Counterfeiter/PowerMeter-PCB/README.md

PowerMeter Schematic and PCB Files
==============

License
--------------
OSH - GPLv2

Software
--------------
Free Version of CADSoft Eagle v6 (.1)

Included
--------------
- versions history
- zipped farbication files (gerber, drill files)
- schematic
- PCB design
- Mouser BOM
