Counterfeiter/PowerMeter-PCB/Image/PowerMeterPCB.png

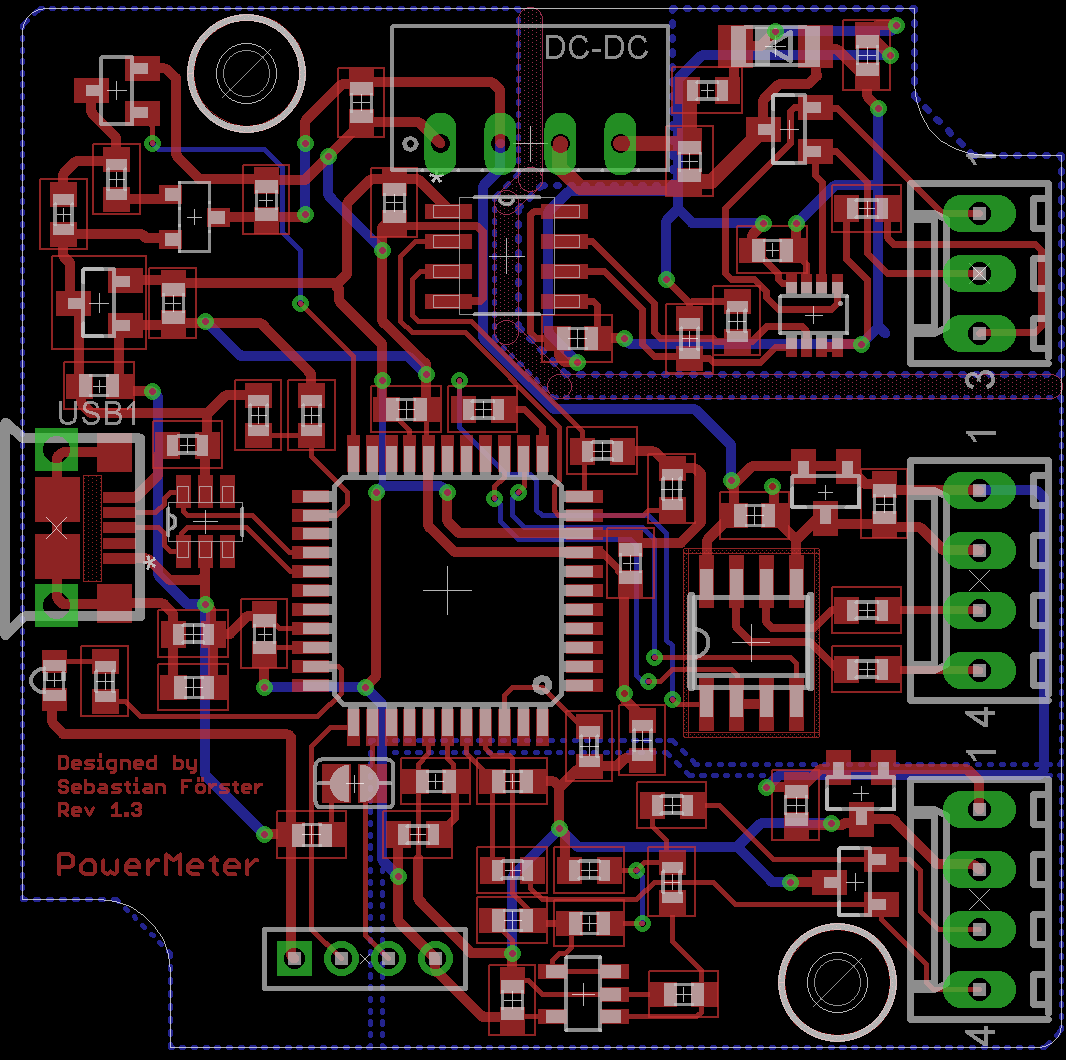
Image/PowerMeterPCB.png
