Counterfeiter/PowerMeter-PCB/Image/PowerMeterSchematic.png

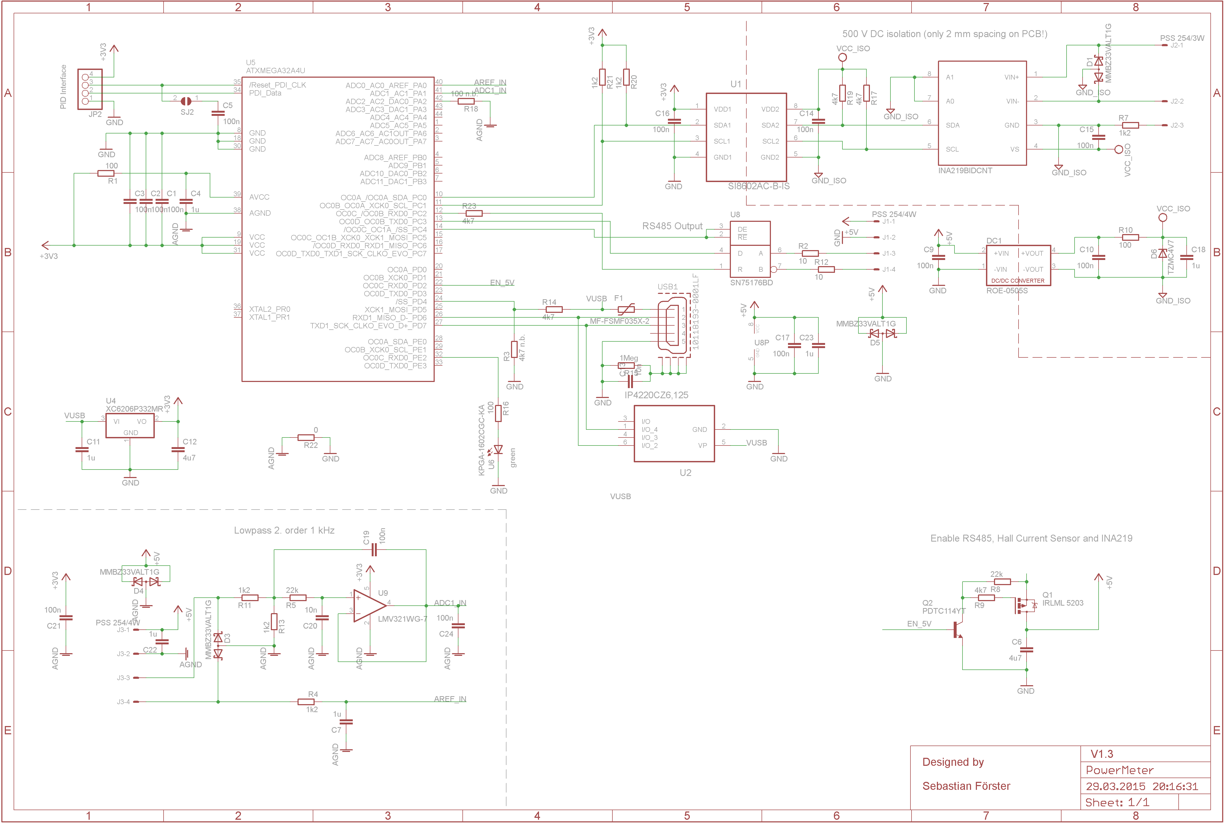
Image/PowerMeterSchematic.png
