Counterfeiter/PowerMeter-PCB/BOM/Mouser_PowerMeter.xlsx

Qty | Value | Package | Name | Order Number Mouser | Review
13 | 100n | C0603 | Kondensator | 81-GRM188R71E104JA1D | okay
6 | 1µ | C0603 | Kondensator | 581-0603YC105JAT2A | okay
2 | 4,7µ | C0603 | Kondensator | 81-ZRB18AR6YA475KE5L | okay
2 | 10n | C0603 | Kondensator | 810-CGA3E2C0G1H103J | okay
4 | MMBZ33VALT1G/BAS40-60 | SOT23 | Diode | 863-MMBZ33VALT1G | okay
1 | TZMC4V7 | SOD80C | Z-Diode | 78-TZMC4.7 | okay
1 | ROE-0505S | NME | dc Wandler | 919-ROE-0505S | okay
1 | MF-FSMF035X-2 | R0603 | Sicherung | 652-MFFSMF035X-2 | okay
2 | PSS 254/4W | 6410-04 | Pinleiste | 538-22-05-7048 | okay
1 | PSS 254/3W | 6410-03 | Pinleiste | 538-22-05-3031 | okay
1 |  |  | Steckerleiste | 538-22-01-3037 | okay
2 |  |  | Steckerleiste | 538-22-01-2045 | okay
11 |  |  | Steckerpins | 538-08-50-0114 | okay
1 | IRLML 5203 | MICRO3 | Transistor | 942-IRLML5203TRPBF | okay
1 | PDTC114YT | SOT23 | Transistor | 771-PDTC114YTT/R | okay
4 | 100 | R0603 | Widerstand | 71-CRCW0603-100-E3 | okay
2 | 10 | R0603 | Widerstand | 71-CRCW0603-10-E3 | okay
6 | 4k7 | R0603 | Widerstand | 71-CRCW0603-4.7K-E3 | okay
6 | 1k2 | R0603 | Widerstand | 71-TNPW06031K20BEEA | okay
2 | 22k | R0603 | Widerstand | 71-TNPW060322K0BEEA | okay
1 | 1M | R0603 | Widerstand | 71-CRCW0603-1.0M-E3 | okay
1 | 0 | R0603 | Widerstand | 71-CRCW0603-0-E3 | okay
1 | 800 |  | Hallsensor | Farnell-9135766 | Farnell! 800 A Example
1 | SI8602AC-B-IS/ADUM1250ARZ | SOIC127P600X175-8N | ADUM1250 | 634-SI8602AC-B-IS | okay
1 | IP4220CZ6,125/IP4220CZ6 | SOT95P275X110-6N | USB-ESD-NXP | 771-IP4220CZ6-T/R | okay
1 | XC6206P332MR | SOT23 | MCP1700T | 579-MCP1700T3302E/TT | okay
1 | ATXMEGA32A4U/AVR-XMEGA-A4U | TQFP44 | xmega | 556-ATXMEGA32A4U-AU | okay
1 | KPGA-1602CGC-KA/APA1606SURCK | CHIP-LED0603 | LED-Sideview | 604-APA1606ZGC | okay
1 | INA219BIDCNT | SOT23-8 | INA219 | 595-INA219BIDCNT | okay
1 | SN75176BD | SO-08 | texas | 595-SN75176BDR | okay
1 | LMV321WG-7 | SOT25-5 | linear | 621-LMV321WG-7 | okay
1 | 10118193-0001LF | MOLEX-47364-0001 | USB-con-Update | 649-10118193-0001LF | okay
1 | 1551RFLBK | Gehäuse | Gehäuse | 546-1551RFLBK | okay
