Counterfeiter/PowerMeter-PCB/PowerMeter.brd

## EAGLE design PowerMeter.brd (2015-04-04)

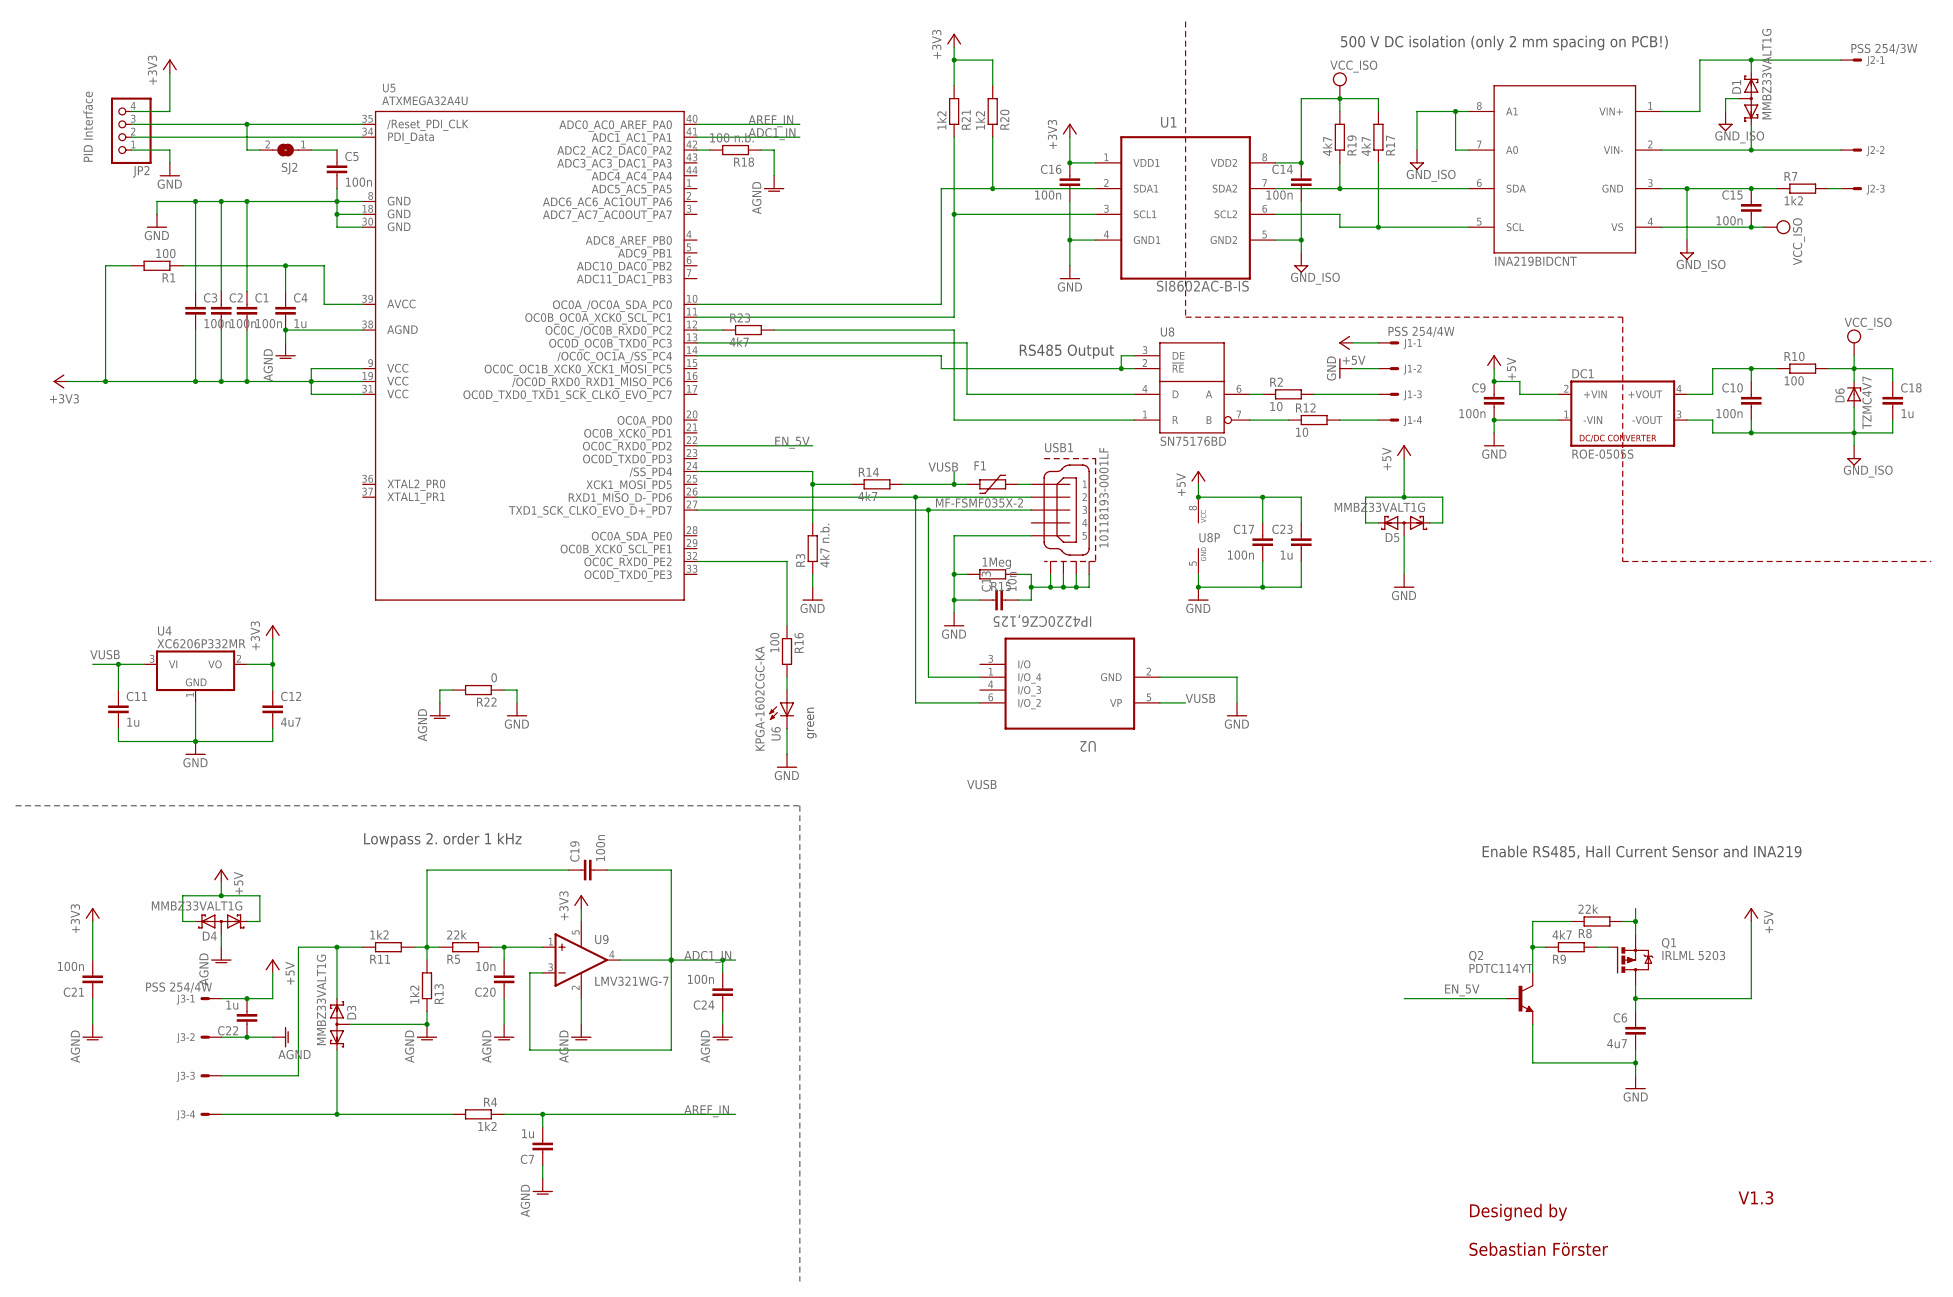
[picture p3: schematic PowerMeter.sch]

Parts:
C1, C2, C3, C5, C9, C10, C14, C15, C16, C17, C19, C21, C24: 100n; C0603
C4, C7, C11, C18, C22, C23: 1u; C0603
C6, C12: 4u7; C0603
C13, C20: 10n; C0603
D1, D3, D4, D5: MMBZ33VALT1G; SOT23
D6: TZMC4V7; SOD80C
DC1: ROE-0505S; NME
F1: MF-FSMF035X-2; R0603
J1, J3: PSS 254/4W; 6410-04
J2: PSS 254/3W; 6410-03
JP2: PINHD-1X4_2.00; 1X04M
Q1: IRLML 5203; MICRO3
Q2: PDTC114YT; SOT23
R1, R10, R16: 100; R0603
R2, R12: 10; R0603
R3: 4k7 n.b.; R0603
R4, R7, R11, R13, R20, R21: 1k2; R0603
R5, R8: 22k; R0603
R9, R14, R17, R19, R23: 4k7; R0603
R15: 1Meg; R0603
R18: 100 n.b.; R0603
R22: 0; R0603
SJ2: SJ
U1: SI8602AC-B-IS; SOIC127P600X175-8N
U2: IP4220CZ6,125; SOT95P275X110-6N
U4: XC6206P332MR; SOT23
U5: ATXMEGA32A4U; TQFP44
U6: KPGA-1602CGC-KA; CHIP-LED0603
U7: INA219BIDCNT; SOT23-6
U8: SN75176BD; SO-08
U9: LMV321WG-7; SOT23-5
USB1: 10118193-0001LF; MOLEX-47364-0001

Connections:
+3V3: C1.2, C2.2, C3.2, C12.1, C16.1, C21.2, JP2.4, R1.2, R20.2, R21.2, U1.1 (VDD1), U4.2 (VO), U5.9 (VCC1), U5.19 (VCC2), U5.31 (VCC3), U9.5 (V+)
+5V: C6.1, C9.1, C17.1, C22.2, C23.1, D4.1 (K1), D4.2 (K2), D5.1 (K1), D5.2 (K2), DC1.2 (+VIN), J1.1, J3.1, Q1.3 (D), U8.8 (VCC)
ADC1_IN: C19.2, C24.2, U5.41 (PA1), U9.3 (-IN), U9.4 (OUT)
AGND: C4.2, C7.1, C20.1, C21.1, C22.1, C24.1, D3.3 (AA), D4.3 (AA), J3.2, R13.1, R18.1, R22.2, U5.38 (AGND), U9.2 (V-)
AREF_IN: C7.2, R4.1, U5.40 (PA0)
EN_5V: Q2.1 (B), U5.22 (PD2)
GND: C1.1, C2.1, C3.1, C5.2, C6.2, C9.2, C11.2, C12.2, C13.1, C16.2, C17.2, C23.2, D5.3 (AA), DC1.1 (-VIN), J1.2, JP2.1, Q2.2 (E), R3.1, R15.2, R22.1, U1.4 (GND1), U2.2 (GND), U4.1 (GND), U5.8 (GND1), U5.18 (GND2), U5.30 (GND3), U6.C, U8.5 (GND), USB1.5
GND1: C10.2, C14.2, C15.1, C18.2, D1.3 (AA), D6.A, DC1.3 (-VOUT), R7.1, U1.5 (GND2), U7.3 (GND), U7.7 (A0), U7.8 (A1)
GPS_ENABLE: Q2.3 (C), R8.1, R9.1
unnamed: R23.2, U8.1 (R)
unnamed: D1.1 (K1), J2.2, U7.2 (VIN-)
unnamed: R20.1, U1.2 (SDA1), U5.10 (PC0)
unnamed: J2.3, R7.2
unnamed: R3.2, R14.1, U5.24 (PD4)
unnamed: D1.2 (K2), J2.1, U7.1 (VIN+)
unnamed: C5.1, SJ2.1
unnamed: C4.1, R1.1, U5.39 (AVCC)
unnamed: JP2.3, SJ2.2, U5.35 (RESET)
unnamed: JP2.2, U5.34 (PDI_DATA)
unnamed: C20.2, R5.2, U9.1 (+IN)
unnamed: R12.1, U8.7 (B)
unnamed: Q1.1 (G), R9.2
unnamed: F1.2, USB1.1
unnamed: J1.3, R2.2
unnamed: R2.1, U8.6 (A)
unnamed: J1.4, R12.2
unnamed: U5.13 (PC3), U8.4 (D)
unnamed: D3.1 (K1), J3.4, R4.2
unnamed: C13.2, R15.1, USB1.GND1, USB1.GND2, USB1.GND3, USB1.GND4
unnamed: U2.6 (I/O_2), U5.26 (PD6), USB1.2
unnamed: C19.1, R5.1, R11.2, R13.2
unnamed: U2.1 (I/O_4), U5.27 (PD7), USB1.3
unnamed: D3.2 (K2), J3.3, R11.1
unnamed: R16.2, U6.A
unnamed: R21.1, U1.3 (SCL1), U5.11 (PC1)
unnamed: U5.14 (PC4), U8.2 (!RE), U8.3 (DE)
unnamed: R17.1, U1.6 (SCL2), U7.5 (SCL)
unnamed: R19.1, U1.7 (SDA2), U7.6 (SDA)
unnamed: R18.2, U5.42 (PA2)
unnamed: R23.1, U5.12 (PC2)
unnamed: R16.1, U5.32 (PE2)
VCC: C14.1, C15.2, C18.1, D6.C, R10.2, R17.2, R19.2, U1.8 (VDD2), U7.4 (VS)
VCC_ISO: C10.1, DC1.4 (+VOUT), R10.1
VUSB: C11.1, F1.1, Q1.2 (S), R8.2, R14.2, U2.5 (VP), U4.3 (VI)

Notes on the sheet:
PID Interface
Designed by
Sebastian Förster
green
INA219BIDCNT
V1.3
Lowpass 2. order 1 kHz
Enable RS485, Hall Current Sensor and INA219
RS485 Output
500 V DC isolation (only 2 mm spacing on PCB!)

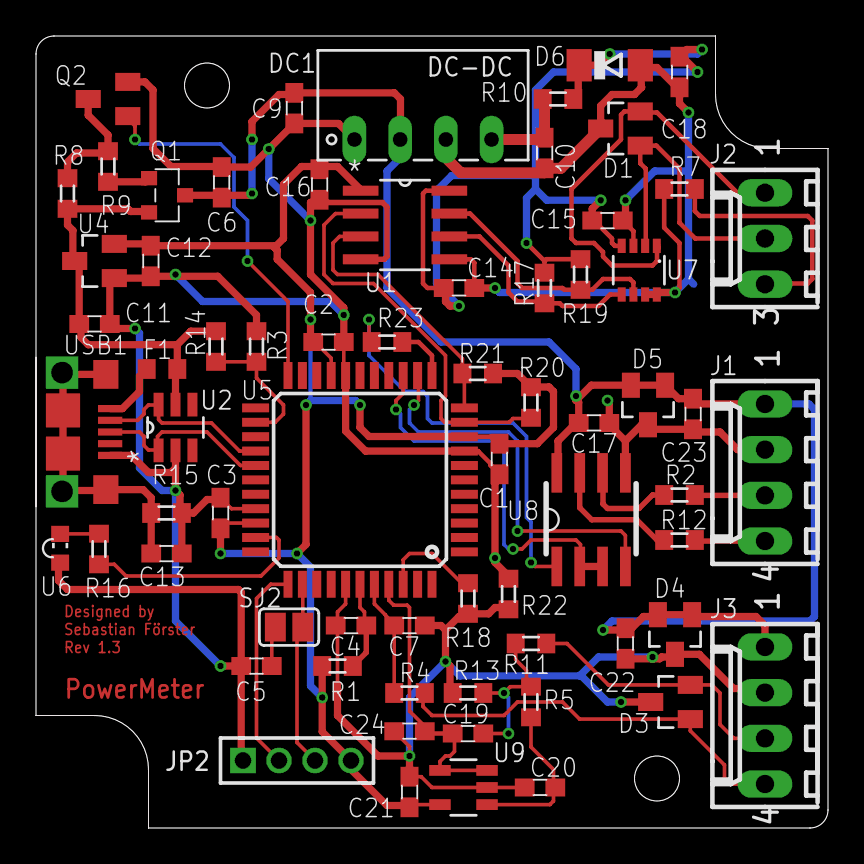
[picture p4: board PowerMeter.brd from above]

Board: 2 copper layers, 44.0 x 44.0 mm, 68 parts (0 on the bottom side), 44 nets.
