Counterfeiter/PowerMeter-PCB/(threads)

Thread 1 (2018-12-21):

Capacitive load of LMV321 to high

Counterfeiter, 2018-12-21:
100 nF are to much load for the LMV321 configuration!

See Datasheet:
http://www.ti.com/lit/ds/symlink/lmv324-n-q1.pdf
Section 8.3.1 Capacitive Load Tolerance

Fix with Riso or lighter (pF Cap)
