Counterfeiter/PowerMeter-PCB/(commit log)

2015-04-04 init commit
    [PowerMeter.brd, PowerMeter.sch]
2016-02-09 - added BOM for mouser
    [Mouser_PowerMeter.xlsx]
